jackbackrack/sisyphos-ai/datasheets/board_preview.png

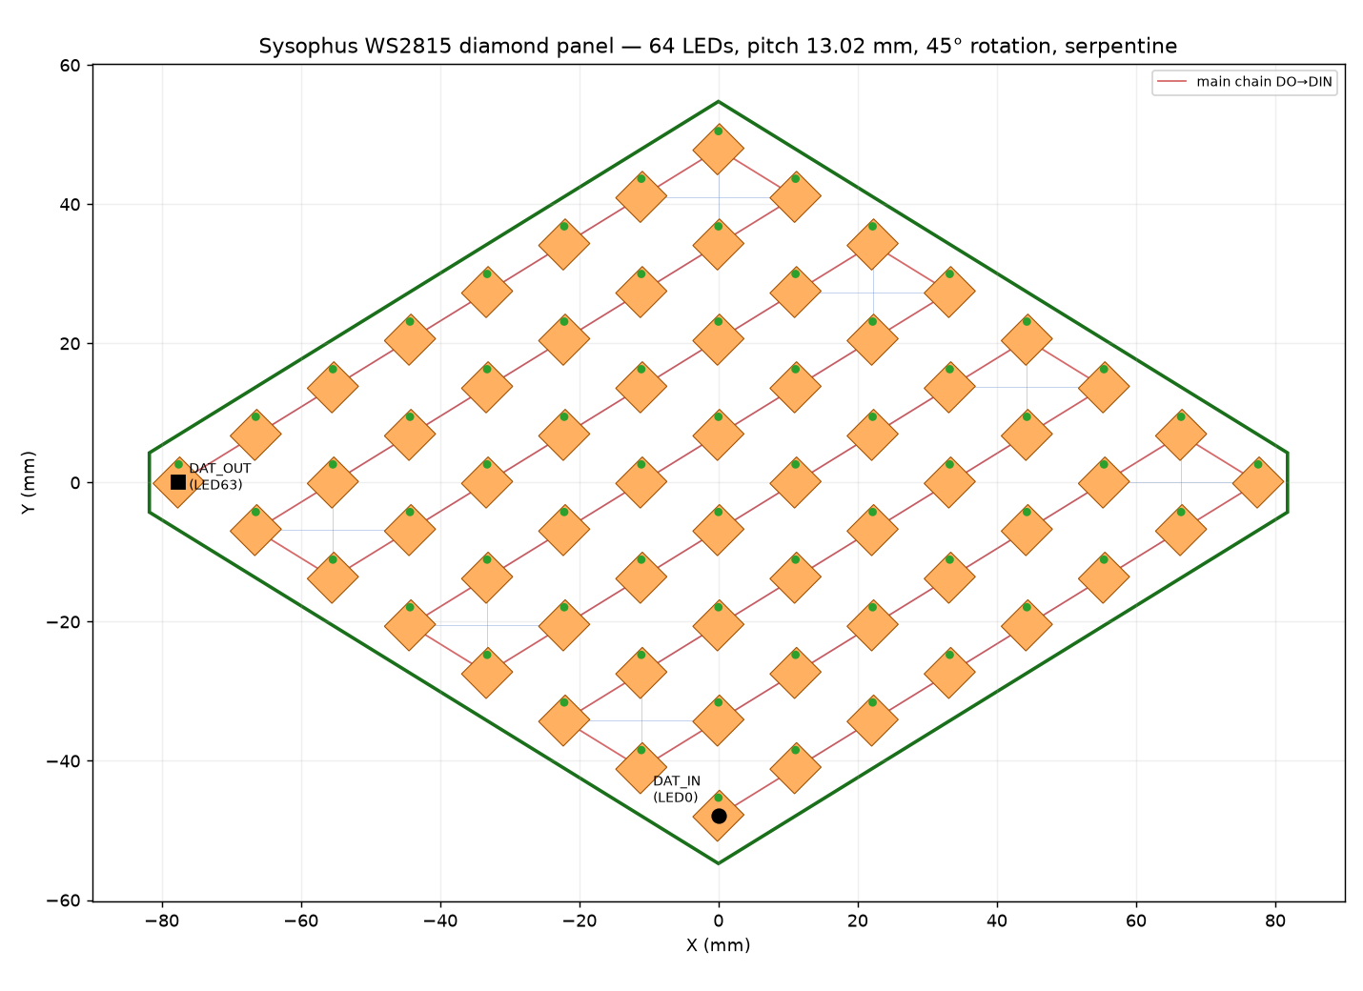
datasheets/board_preview.png
