jackbackrack/sisyphos-ai/datasheets/board_preview_holes.png

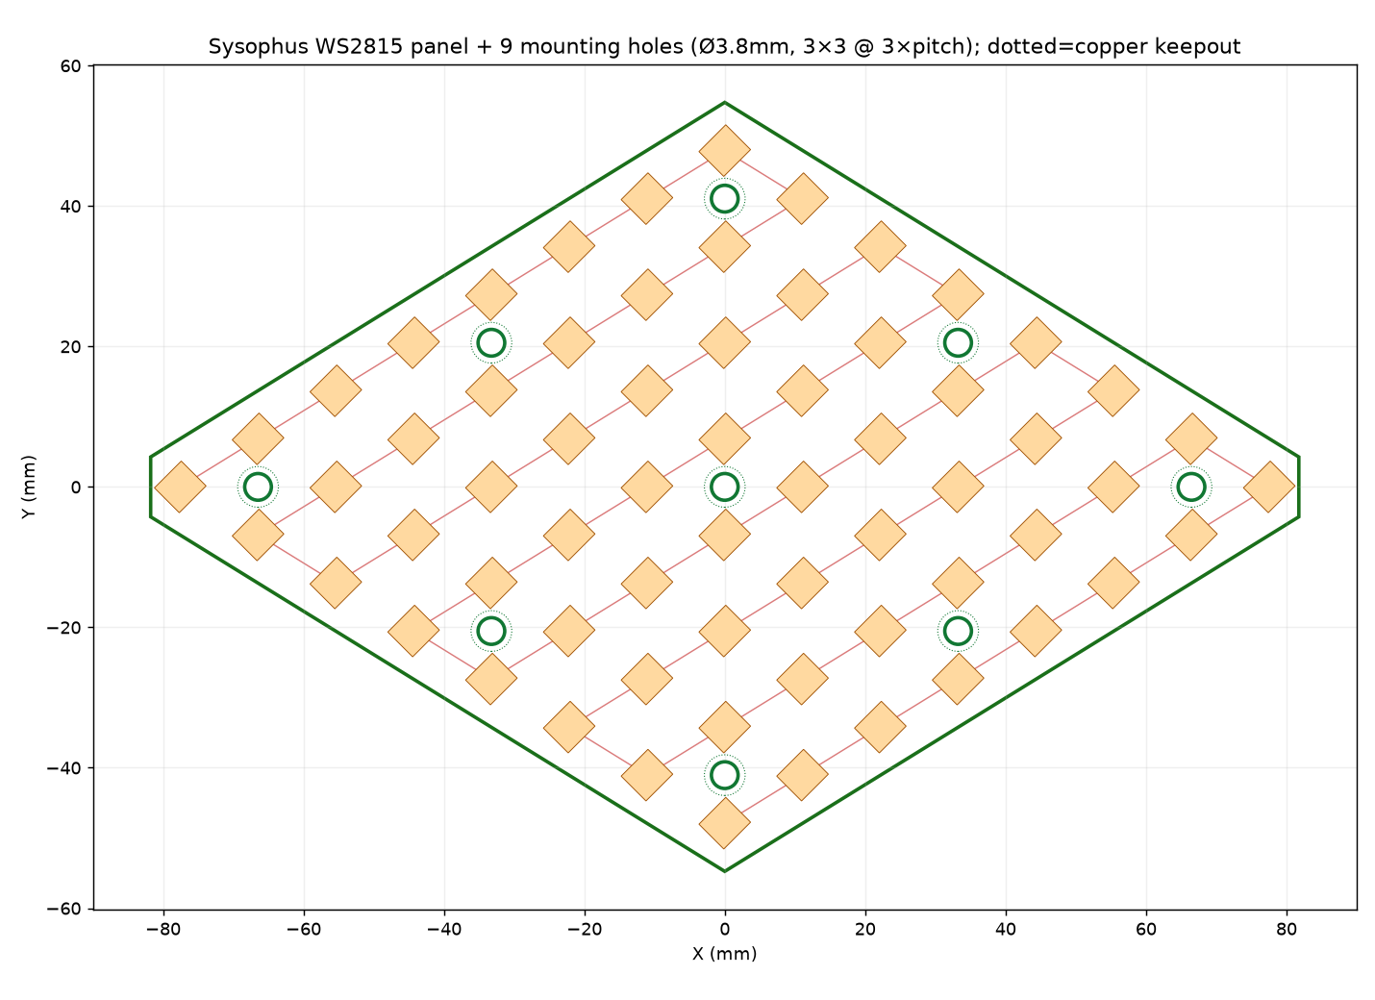
datasheets/board_preview_holes.png
