jackbackrack/sisyphos-ai/datasheets/cap_placement2.png

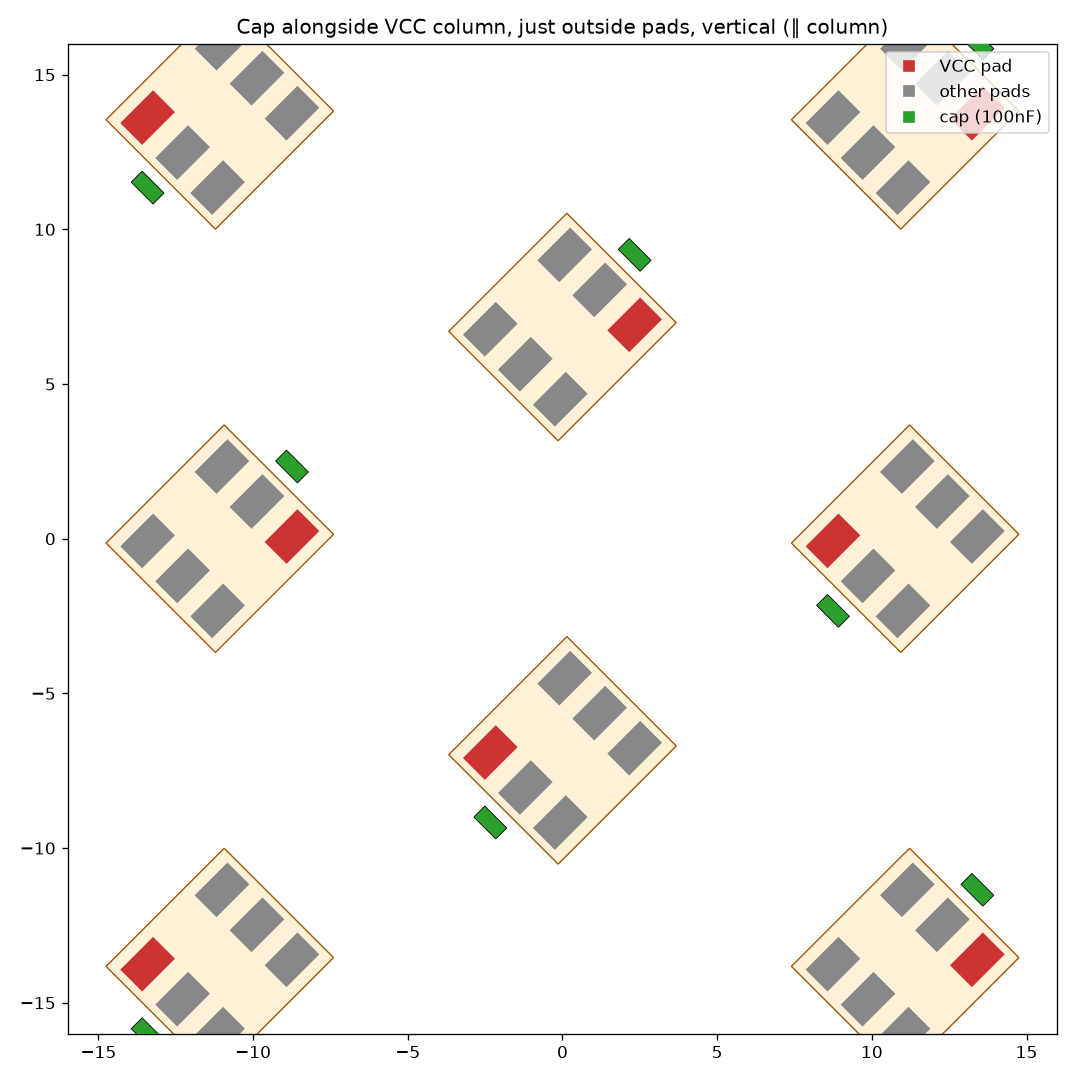
datasheets/cap_placement2.png
