jackbackrack/sisyphos-ai/datasheets/cap_placement.png

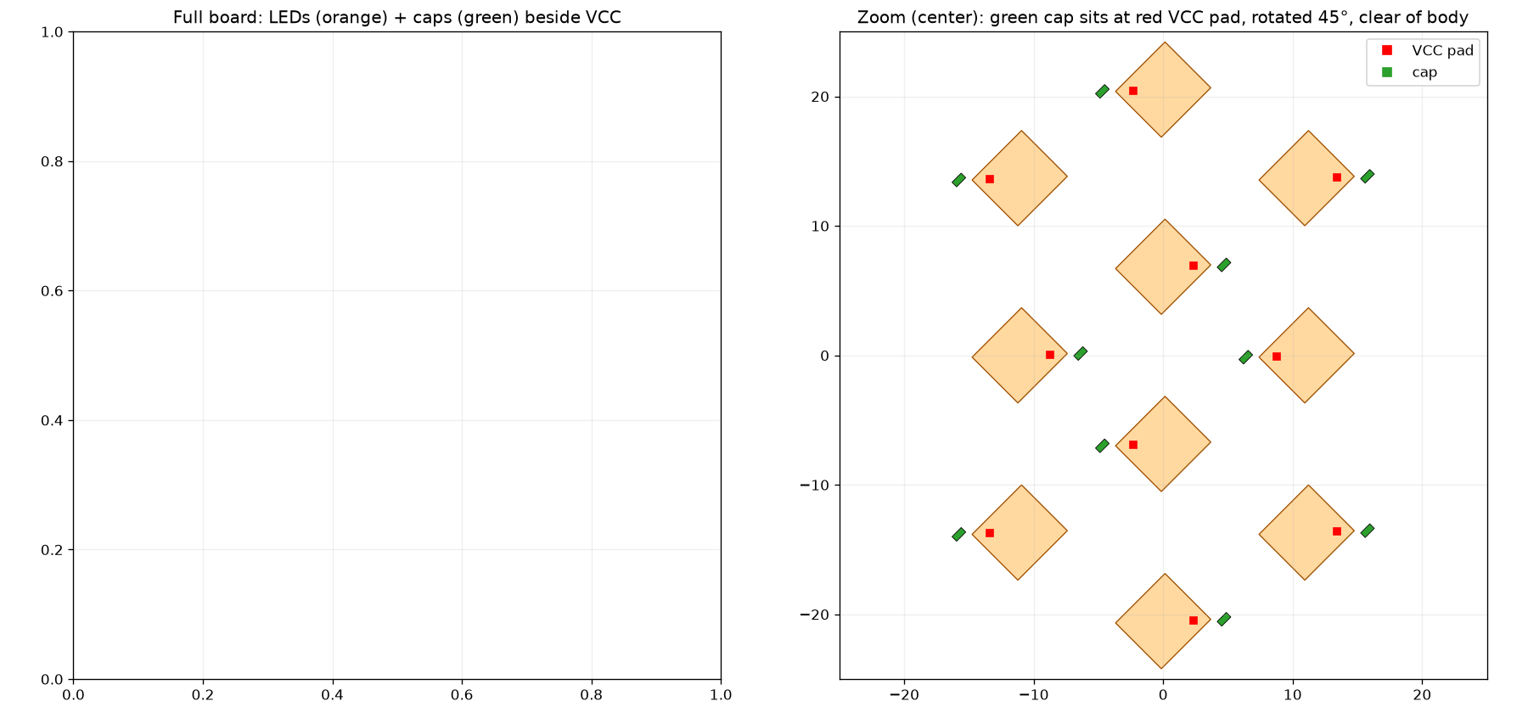
datasheets/cap_placement.png
