jackbackrack/sisyphos-ai/datasheets/connectors_inward.png

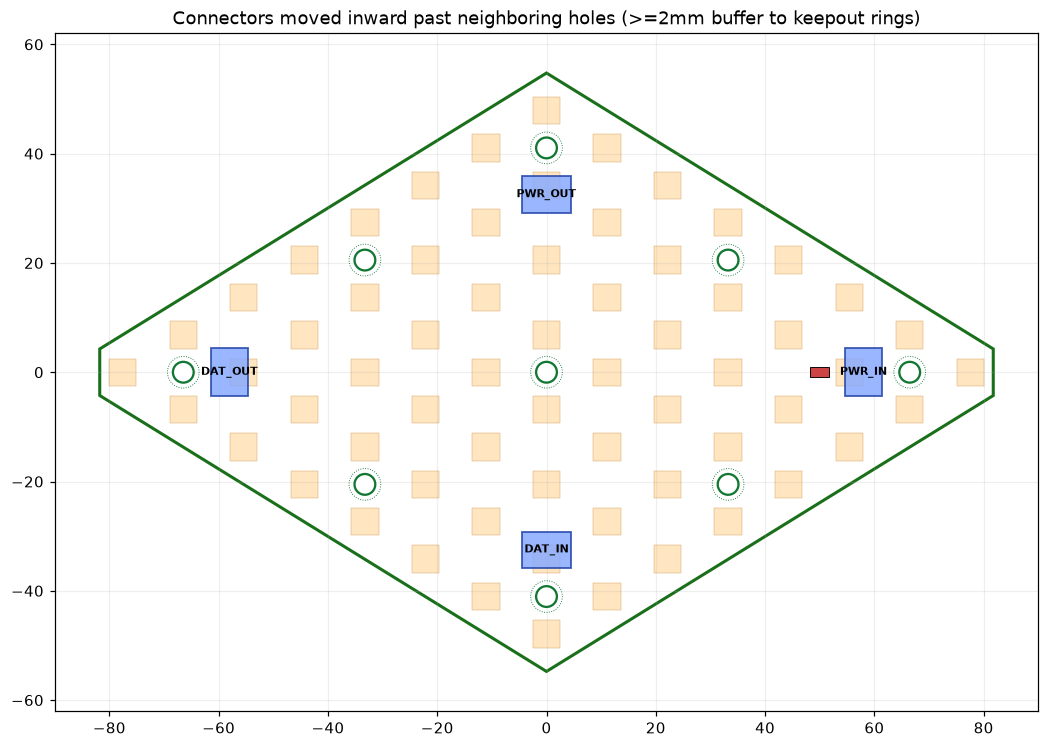
datasheets/connectors_inward.png
