jackbackrack/sisyphos-ai/datasheets/connectors_layout.png

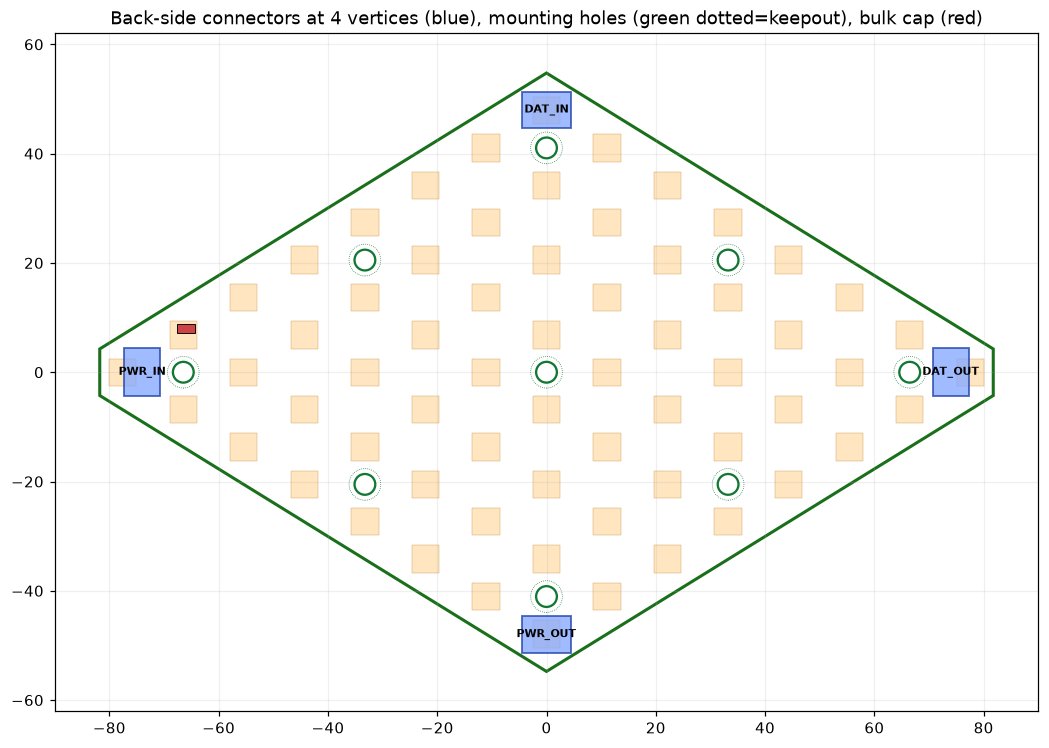
datasheets/connectors_layout.png
