jackbackrack/sisyphos-ai/datasheets/rotated180.png

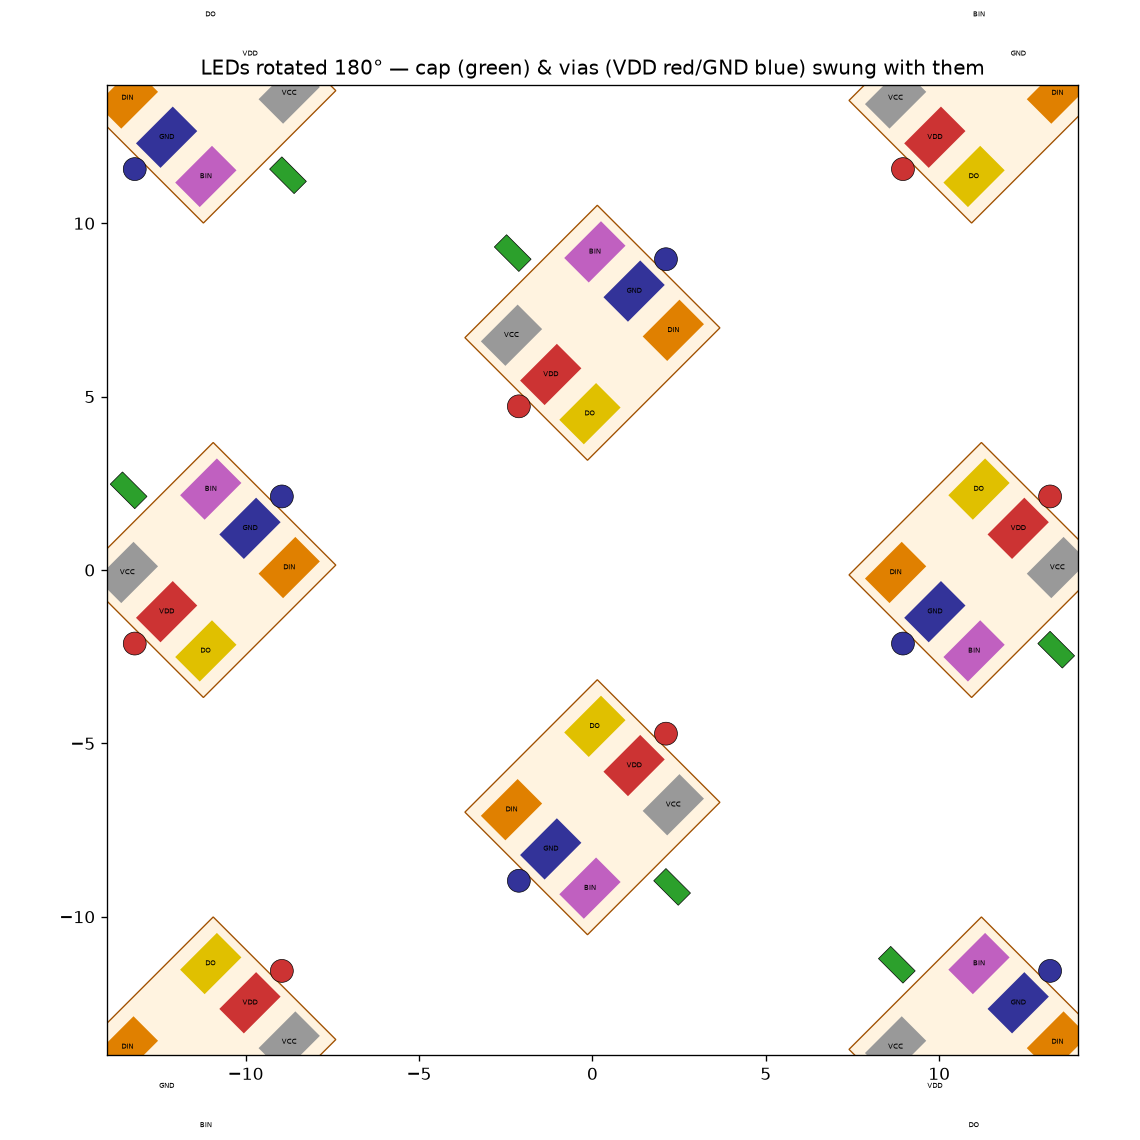
datasheets/rotated180.png
