jackbackrack/sisyphos-ai/datasheets/via_placement.png

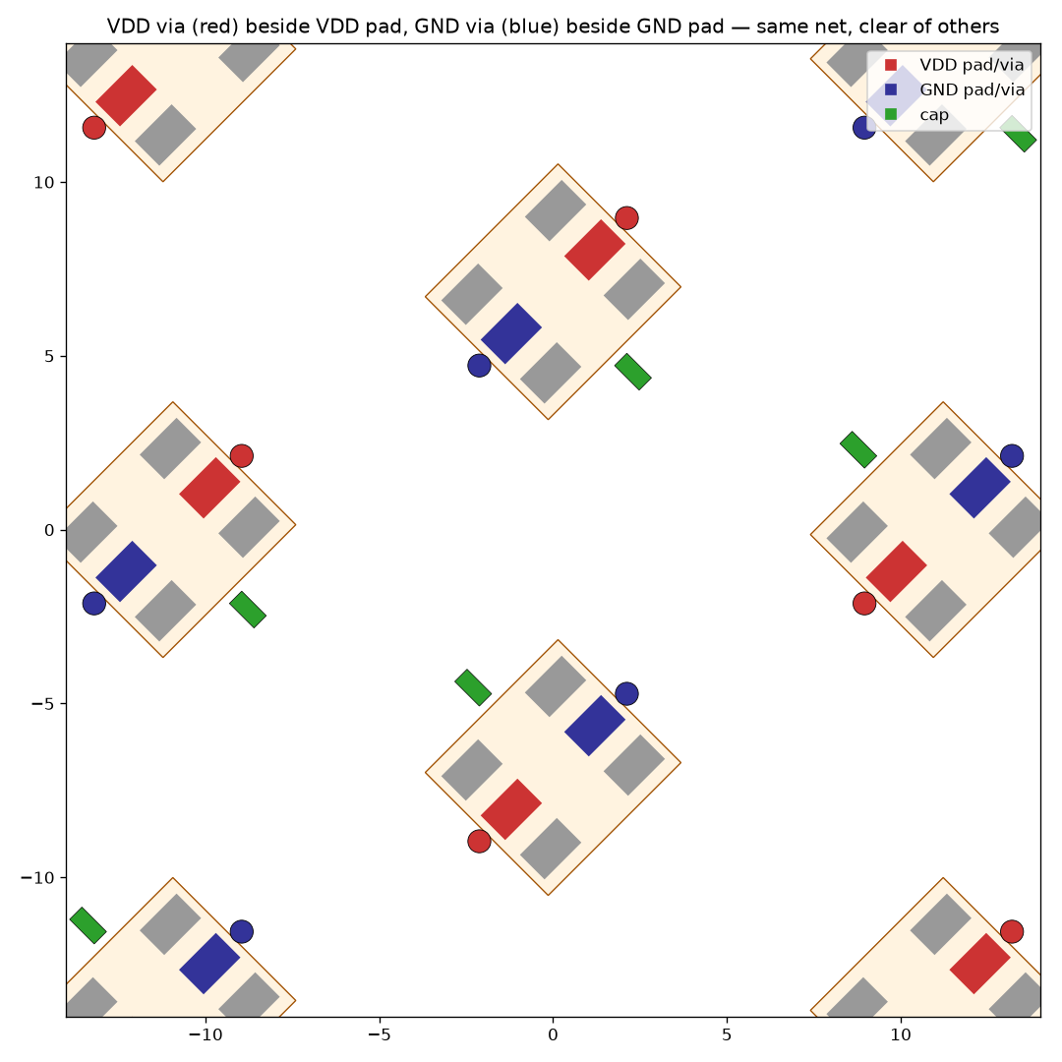
datasheets/via_placement.png
