jackbackrack/sisyphos-ai/datasheets/ws2815_body.png

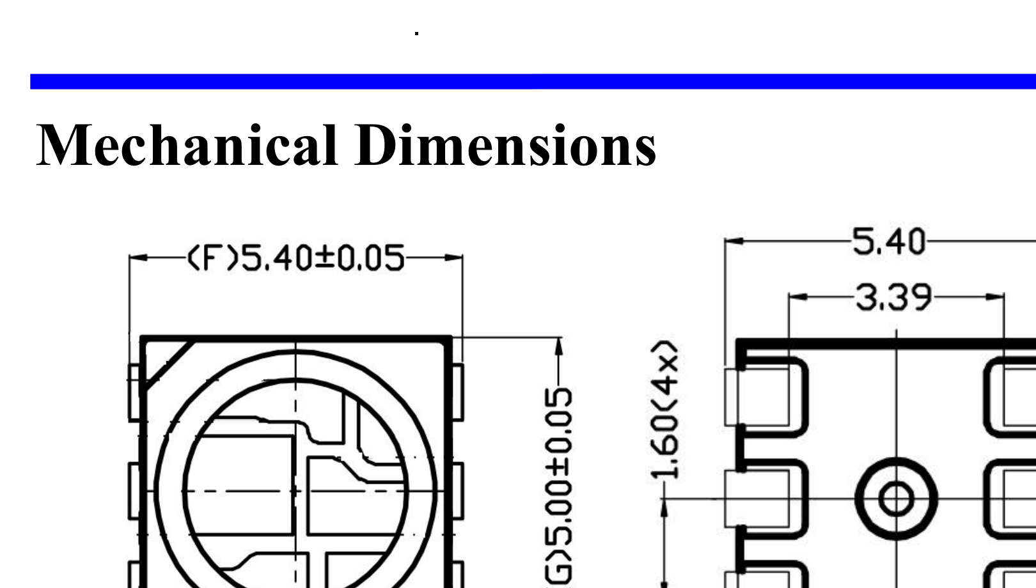
datasheets/ws2815_body.png
