jackbackrack/sisyphos-ai/datasheets/ws2815_mech.png

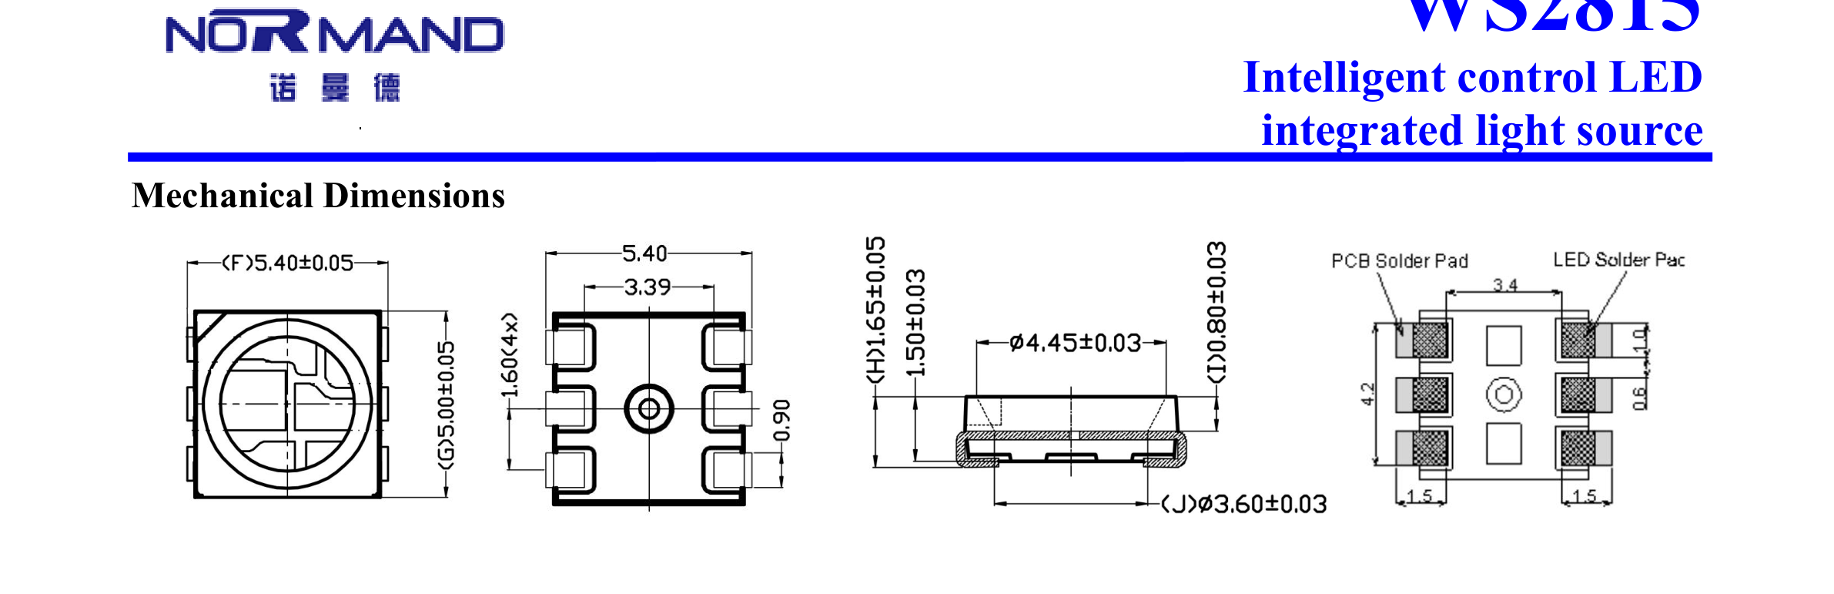
datasheets/ws2815_mech.png
