jackbackrack/sisyphos-ai/datasheets/ws2815_p2_full.png

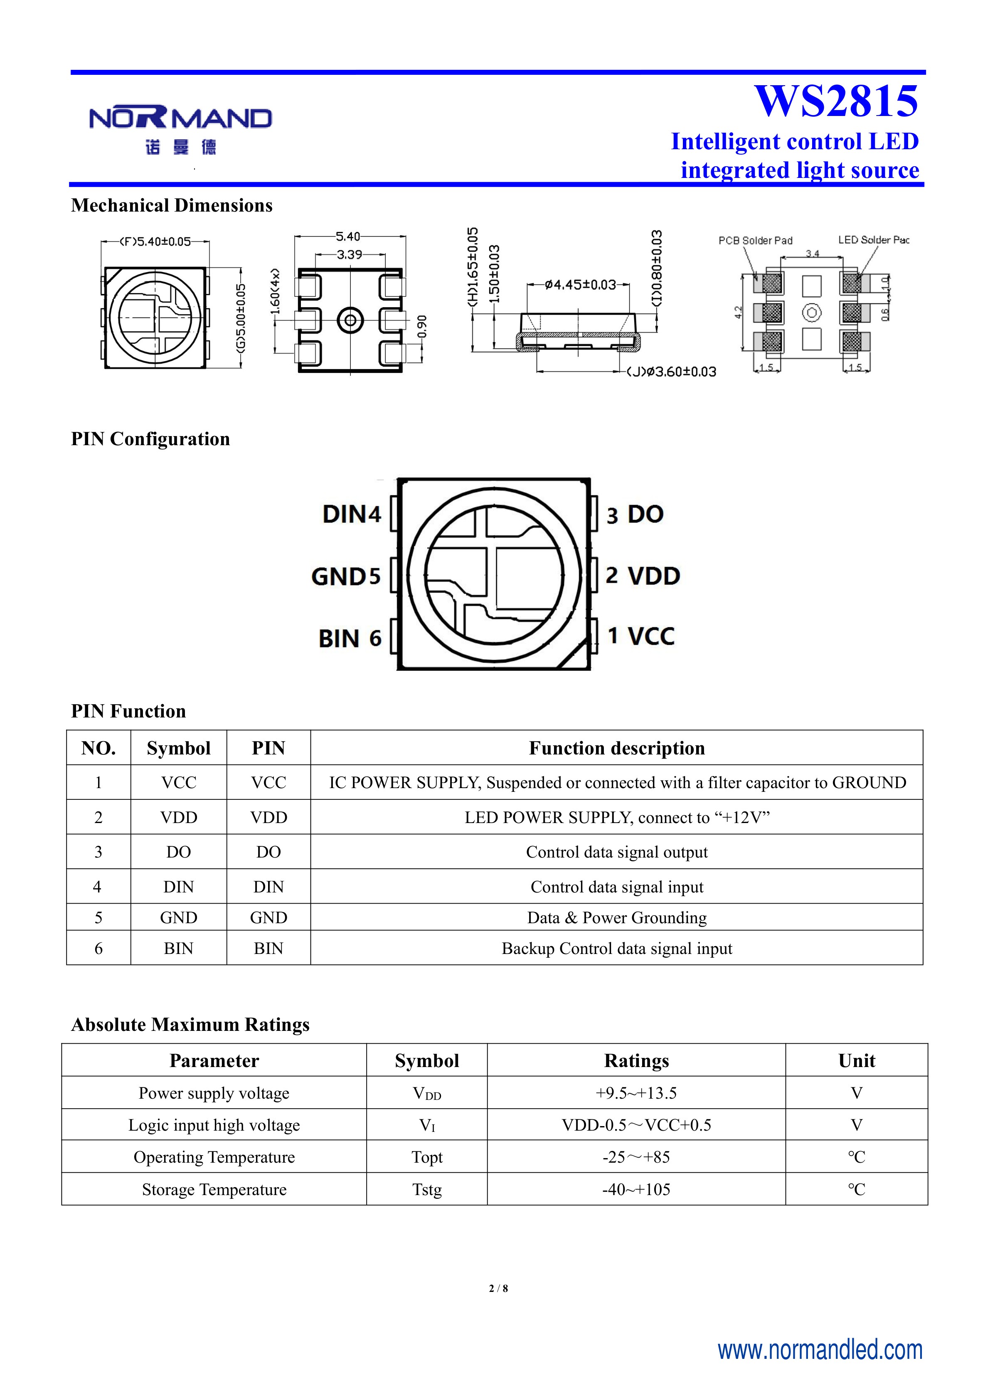
datasheets/ws2815_p2_full.png
