jackbackrack/sisyphos-ai/datasheets/ws2815_pcbpad2.png

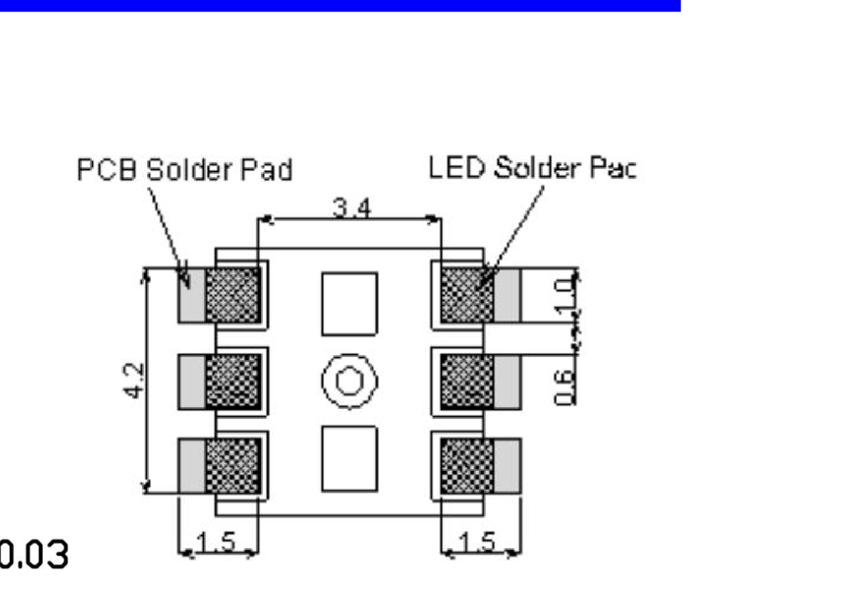
datasheets/ws2815_pcbpad2.png
