jackbackrack/sisyphos-ai/datasheets/ws2815_pcbpad.png

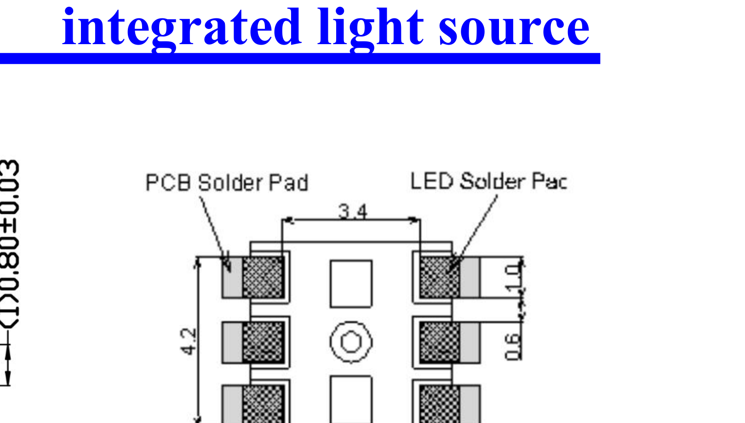
datasheets/ws2815_pcbpad.png
