jackbackrack/sisyphos-ai/3d-models/jitx-64d1493ab789d8dc4b7b3f0a.stp

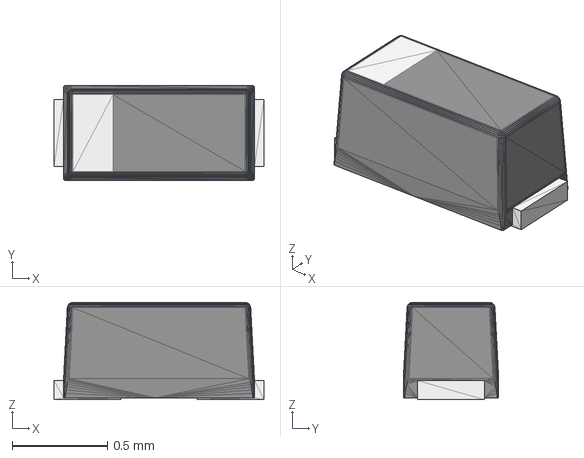
[picture p14: CAD file, 2026-09-08]
3d-models/jitx-64d1493ab789d8dc4b7b3f0a.stp
1.10 x 0.5 x 0.51 mm
