jackbackrack/sisyphos-ai/3d-models/jitx-64d169e4b789d8dc4b7ef163.stp

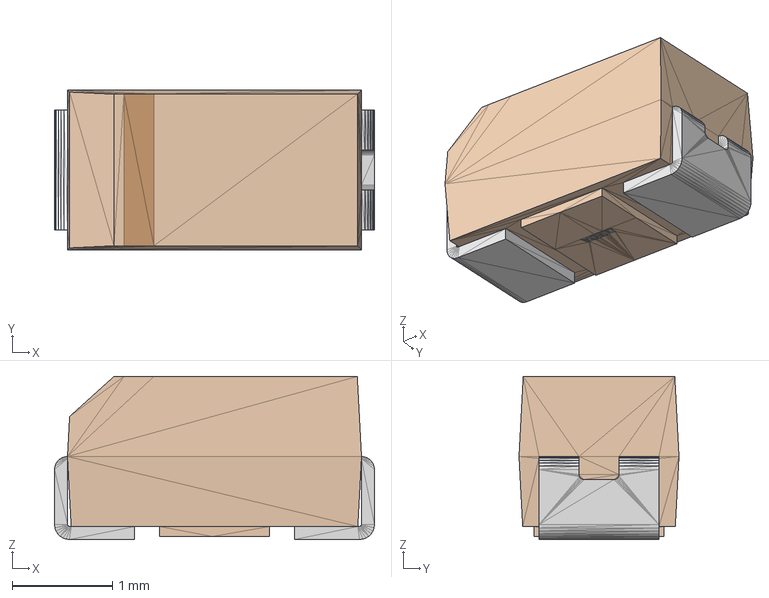
[picture p15: CAD file, 2026-09-08]
3d-models/jitx-64d169e4b789d8dc4b7ef163.stp
3.20 x 1.60 x 1.63 mm
