jackbackrack/sisyphos-ai/3d-models/jitx-64d20a57b789d8dc4b9133e2.stp

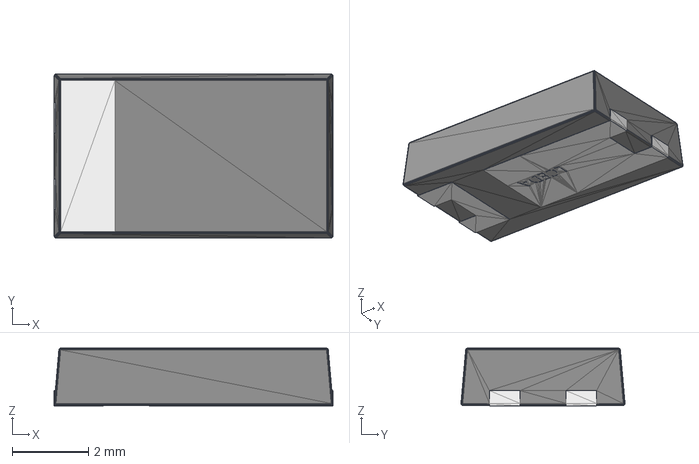
[picture p16: CAD file, 2026-09-08]
3d-models/jitx-64d20a57b789d8dc4b9133e2.stp
7.30 x 4.29 x 1.51 mm
