jackbackrack/sisyphos-ai/3d-models/jitx-64d24443b789d8dc4b979c1f.stp

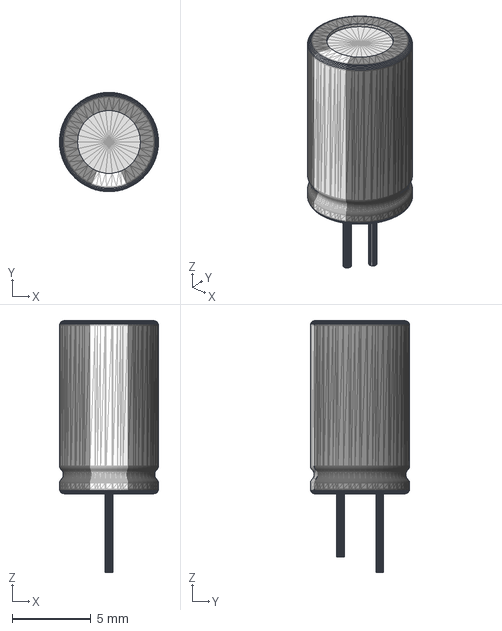
[picture p17: CAD file, 2026-09-08]
3d-models/jitx-64d24443b789d8dc4b979c1f.stp
6.30 x 6.31 x 16.0 mm
