jackbackrack/sisyphos-ai/3d-models/jitx-64d1464db789d8dc4b7ad30d.stp

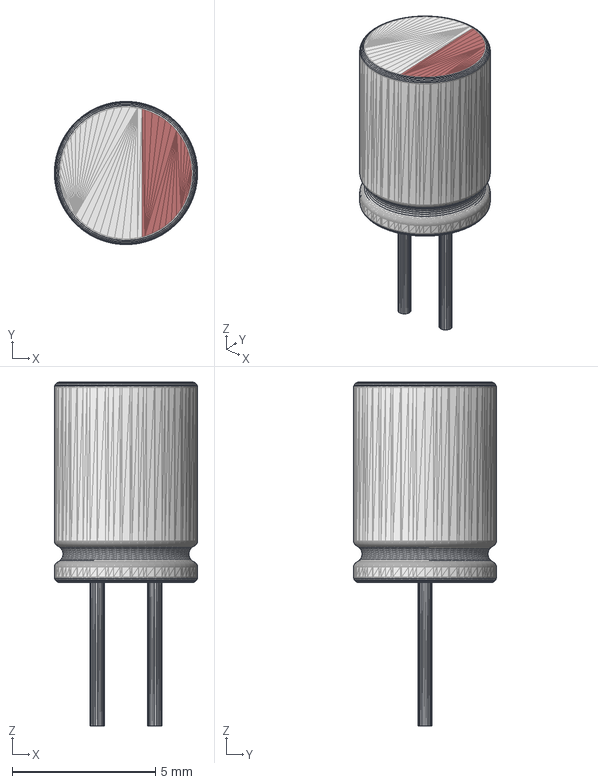
[picture p18: CAD file, 2026-09-08]
3d-models/jitx-64d1464db789d8dc4b7ad30d.stp
5.00 x 4.99 x 12.0 mm
