jackbackrack/sisyphos-ai/3d-models/jitx-64d13eb0b789d8dc4b79e9c7.stp

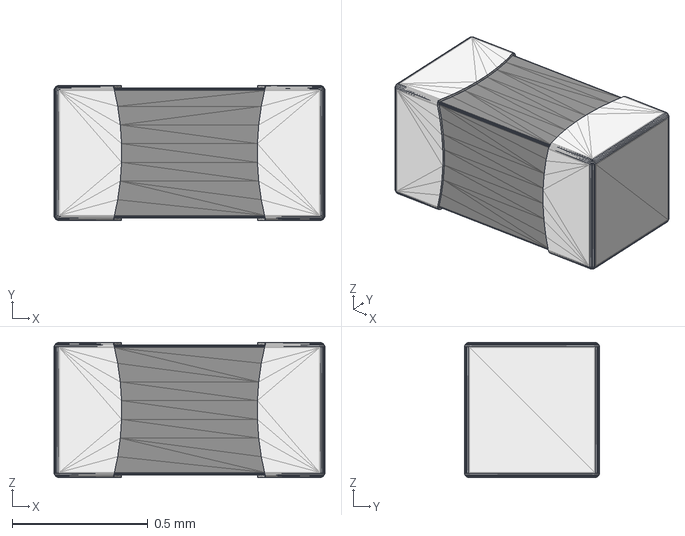
[picture p19: CAD file, 2026-09-08]
3d-models/jitx-64d13eb0b789d8dc4b79e9c7.stp
1.00 x 0.5 x 0.5 mm
