jackbackrack/sisyphos-ai/3d-models/jitx-64d1b74ab789d8dc4b87ea27.stp

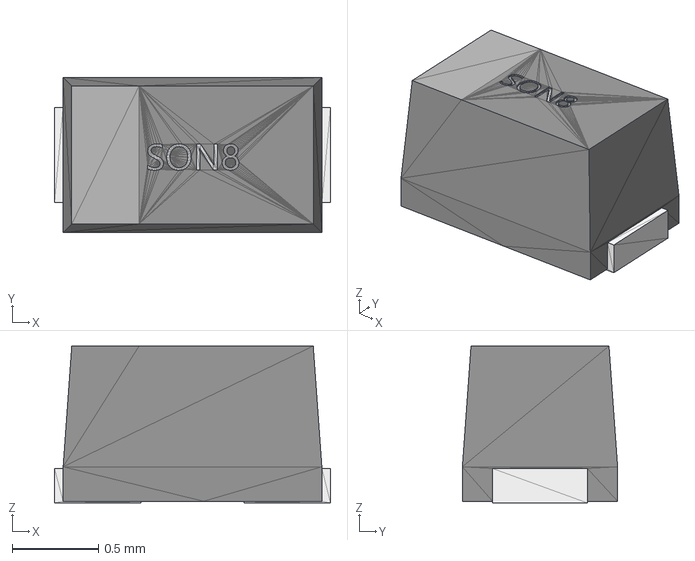
[picture p20: CAD file, 2026-09-08]
3d-models/jitx-64d1b74ab789d8dc4b87ea27.stp
1.60 x 0.9 x 0.91 mm
