jackbackrack/sisyphos-ai/3d-models/jitx-64d157ceb789d8dc4b7cecd5.stp

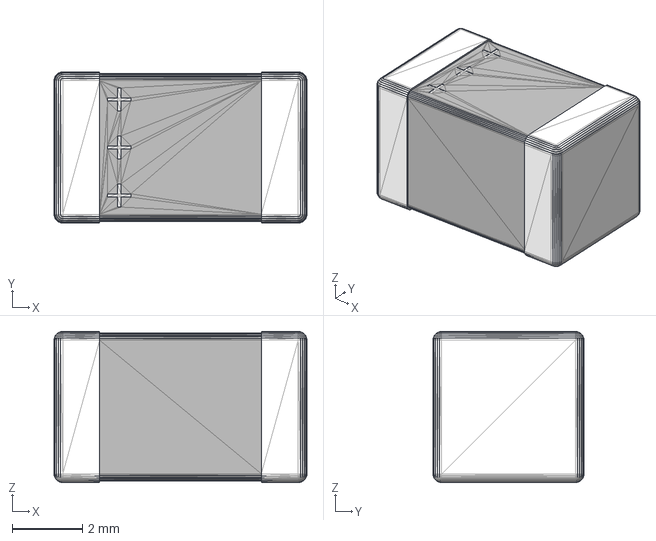
[picture p21: CAD file, 2026-09-08]
3d-models/jitx-64d157ceb789d8dc4b7cecd5.stp
7.20 x 4.30 x 4.30 mm
