jackbackrack/sisyphos-ai/(commit log)

2026-09-08 Initial commit
    Rename sysophus -> sisyphos throughout (package, design identifiers,
    docs, footprint asset path) and exclude generated/byproduct data
    (KiCad exports, build caches, temp dirs, parts-db, venv) from version
    control.
    [jitx-64d13eb0b789d8dc4b79e9c7.stp, jitx-64d1464db789d8dc4b7ad30d.stp, jitx-64d1493ab789d8dc4b7b3f0a.stp, jitx-64d157ceb789d8dc4b7cecd5.stp, jitx-64d169e4b789d8dc4b7ef163.stp, jitx-64d1b74ab789d8dc4b87ea27.stp, jitx-64d20a57b789d8dc4b9133e2.stp, jitx-64d24443b789d8dc4b979c1f.stp]
2026-09-22 Upgrade jitx toolchain to 4.5 pre-release and fix breaking API changes
    Bump jitx/jitxlib-standard/jitxlib-parts/jitxlib-jlcpcb to their
    pre-release lines to pull in JLCPCB export support (jitxlib-parts needed
    a matching bump since it pins jitxlib-standard; jitxexamples-components
    dropped since it's unused here and has no release compatible with the
    new jitxlib-parts yet).
    Fix two breaking changes surfaced by the upgrade:
    - Passive value kwargs (capacitance/rated_voltage/resistance) now require
    unit quantities instead of bare floats.
    - Capacitor/Resistor lost `.insert(a, b)`; wire p1/p2 directly instead.
    Attach LCSCPart(C5446699) to the WS2815 component so the JLCPCB export
    resolves its L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
